BayLibre/Copilot-extension-triple-usb-2.0/README.md

# Copilot Lite - 3xUSB 2.0 extension board

Extension board

This boards mounts on top of the Copilot Lite board, like a Raspberry Pi hat or an Arduino shield.  
It provides 3 additional USB 2.0 passthrough channels which can be controlled by a Copilot Lite GPIO.  
The GPIO controlling each channel can be configured through jumpers.
