BayLibre/Copilot-extension-triple-usb-2.0/images/copilot_ext_3xUSB_top.png

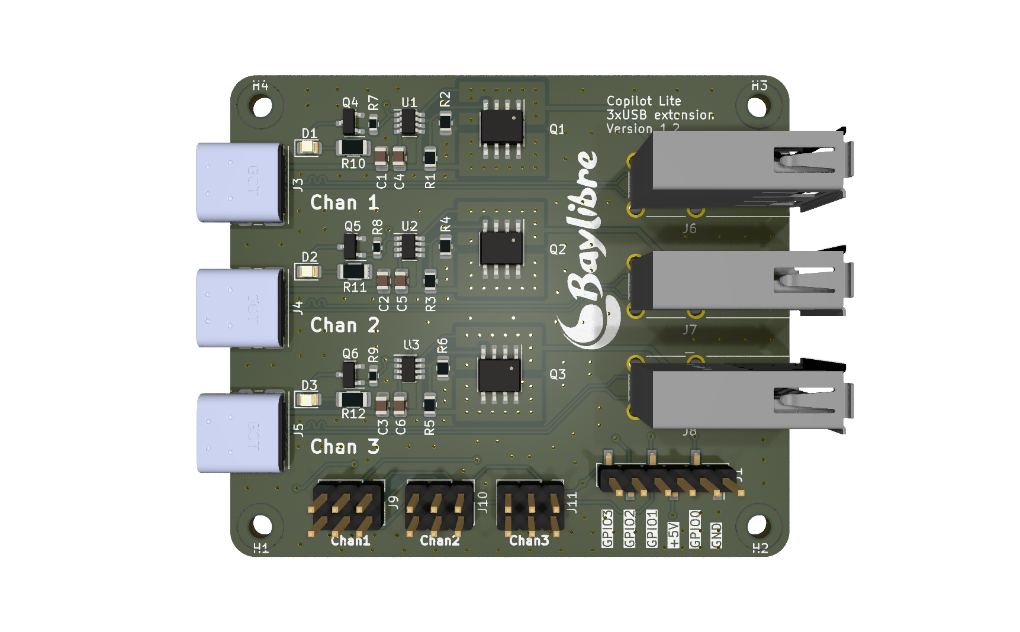
images/copilot_ext_3xUSB_top.png
