BayLibre/Copilot-extension-triple-usb-2.0/(commit log)

2025-04-04 Improvements and fixes
    - Change configuration pins
    - Add documentaiton on back of the board
    - increase type-C power line width
    - Align headers
    [copilot-ext-3xUSB.kicad_pcb, copilot-ext-3xUSB.kicad_sch]
2025-05-13 Export locally and relink project:
    - Export 3D models
    - Export Schematic symbols
    - Export PCB footprints
    - Relink local 3D models to local footprints
    - Relink local schematic symbols to local footprints
    [copilot-ext-3xUSB.kicad_pcb, copilot-ext-3xUSB.kicad_sch]
2025-05-22 Fix inverted silkscreen documentation
    [copilot-ext-3xUSB.kicad_pcb]
2025-06-05 Update the project to KiCad 9.
    [copilot-ext-3xUSB.kicad_pcb, copilot-ext-3xUSB.kicad_sch]
2025-06-05 Assign a manufacturer part number to each board component.
    [copilot-ext-3xUSB.kicad_pcb, copilot-ext-3xUSB.kicad_sch]
2025-06-05 Set the gerber files output directory.
    [copilot-ext-3xUSB.kicad_pcb]
2025-06-05 Add the board origin point for drilling and components assembly.
    [copilot-ext-3xUSB.kicad_pcb]
2025-06-05 Add the assembly output directory that stores the pick and place files.
2025-06-10 Improve the USB-C connectors Vbus trace isolation.
    [copilot-ext-3xUSB.kicad_pcb]
2025-06-10 Add top paste openings to the USB4085 USB-C connector as it is reflowable.
    [copilot-ext-3xUSB.kicad_pcb]
2025-06-10 Bump the PCB version to 1.1.
    [copilot-ext-3xUSB.kicad_pcb]
2025-06-10 Adjust the net class clearances to fix all PCB DRC errors.
    [copilot-ext-3xUSB.kicad_pcb]
2025-06-10 Add a script to panelize the board using KiKit.
2025-06-11 Add more vias for better heat dissipation. Align some tracks.
    [copilot-ext-3xUSB.kicad_pcb]
2025-10-30 Fix the channels GPIO silkcreen text because the pins were inverted.
    Also bumped the board version to 1.2.
    [copilot-ext-3xUSB.kicad_pcb]
2026-01-14 Add title, revision and company name to the schematic and the PCB sheets.
    [copilot-ext-3xUSB.kicad_pcb, copilot-ext-3xUSB.kicad_sch]
2026-01-14 README: Add a board picture and a basic description.
2026-01-14 images: Update the 3D renderings of the board with transparent background pictures.
